sanghviharshit/wandering-hour-clock/(threads)

Thread 1 (2023-05-13):

Clock run backward

nxenara, 2023-05-13:
Hello,

The clock is running counterclockwise.
With this change the clock turns clockwise but commands, +5minutes, -5minutes, demo and recycle are still reversed.

<code> myStepper.step(-cStep); //inversion du mouvement, cStep modifié en -cStep </code>

This is certainly not the right solution.

Thank you for your help.

Nxenara

sanghviharshit, 2023-05-15:
I think there might be an issue with the wiring order. Have you tested it with a basic sketch from [ESP32](https://randomnerdtutorials.com/esp32-stepper-motor-28byj-48-uln2003/) or [ESP8266](https://randomnerdtutorials.com/esp8266-nodemcu-stepper-motor-28byj-48-uln2003/)?

Closed 2023-12-21.

Thread 2 (2023-08-21):

Your wiring diagram is not exactly what you have in ur pictures.

Bock326, 2023-08-21:
The schematic shows that both boards are connected to ground and only the stepper driver is power by 5v. In your image of your irl wiring 5v is also connected to the esp32

sanghviharshit, 2023-08-21:
The wiring diagram is from the tutorial I have linked, and it assumes you are powering your ESP32 board using the micro-usb port. I have decided to power the stepper motor and the board from the same power supply. Hope that helps!

Closed 2023-12-21.

Thread 3 (2023-12-12):

How to set up with wifi manager ?

kot0005, 2023-12-12:
How do i change your code to use it with wifi manager in this video : ?

this is to avoid compiling sketch for a new password and ssid.

https://www.youtube.com/watch?v=VnfX9YJbaU8&ab_channel=DroneBotWorkshop

garylefebvreg, 2024-01-05:
[](https://www.youtube.com/watch?v=VnfX9YJbaU8&t=1120s)

This link worked for me and I adjust the sketch code to use the WiFiManager from this video and clear out the sketch WiFi routine...

garylefebvreg, 2024-01-06:
Comment this out becaause WiFi will reset after power is turn off...

//wm.resetSettings();

kot0005, 2024-01-06:
> Comment this out becaause WiFi will reset after power is turn off...
>
> //wm.resetSettings();

i was askign chat GPT for this code and this is what it gave me. It wasnt working though.

#include <WiFiManager.h>
#include <Stepper.h>
#include <ArduinoOTA.h>
#include <WebServer.h>
#include <WiFiUdp.h>
#include <TimeLib.h>

// Function declarations
time_t getNtpMinute();
void setupWiFi();
void handleRoot();
void handleFormSubmit();
void handleFormForward5();
void handleFormBackward5();
void handleFormRecycle();
void handleFormDemo();

// Replace the ssid and password in secrets.h
const char* ssid = "your-ssid";
const char* password = "your-password";

const int stepsPerRev = 2048; // steps / rev for stepper motor
const int maxSpeed = 8;       // max speed stepper RPM, conservative
const int led = 13;           // built-in led

#define IN1 19
#define IN2 18
#define IN3 5
#define IN4 17

int stepDelay;      // minimum delay / step in uSec
unsigned int updateIntervalMinutes = 1;
unsigned long pMinute = 0;
unsigned long cMinute;
unsigned long cHour;
unsigned long pHour;

// Initialize web server library
WebServer server(80); // Create a WebServer object that listens on port 80

// Initialize the stepper library
Stepper myStepper(stepsPerRev, IN1, IN3, IN2, IN4);

// Initialize UDP library
WiFiUDP udp;
unsigned int localPort = 8888;  // local port to listen for UDP packets
int retryCount = 0;             // Wifi connection retry count
const int maxRetryCount = 10;   // Maximum number of retry attempts

// Define the NTP server and timezone offset
static const char ntpServerName[] = "us.pool.ntp.org";
const long timeZoneOffset = -7;  // Pacific Daylight Time (PDT)

void setupWiFi() {
  WiFiManager wifiManager;

  // Uncomment the next line to reset WiFi credentials (for testing purposes)
  // wifiManager.resetSettings();

  if (!wifiManager.autoConnect("AutoConnectAP", "password")) {
    Serial.println("Failed to connect and hit timeout");
    ESP.restart();
    delay(1000);
  }

  Serial.println("Connected to WiFi");
}

void setup() {
  Serial.begin(115200);
  Serial.println("Booting");

  // Setup Wi-Fi connection using WiFiManager
  setupWiFi();

  // Initialize the NTP client and sync with the NTP server
  udp.begin(localPort);
  Serial.print("NTP UDP Local port: ");
  Serial.println(localPort);

  Serial.println("waiting for sync");
  setSyncProvider(getNtpMinute);
  setSyncInterval(300);
  while (timeStatus() == timeNotSet) {
    delay(5000);
  }

  // Set up Arduino OTA

  // Hostname defaults to esp3232-[MAC]
  ArduinoOTA.setHostname("wandering-hour-clock");

  ArduinoOTA
    .onStart([]() {
      String type;
      if (ArduinoOTA.getCommand() == U_FLASH)
        type = "sketch";
      else // U_SPIFFS
        type = "filesystem";

      // NOTE: if updating SPIFFS this would be the place to unmount SPIFFS using SPIFFS.end()
      Serial.println("Start updating " + type);
    })
    .onEnd([]() {
      Serial.println("\nEnd");
    })
    .onProgress([](unsigned int progress, unsigned int total) {
      Serial.printf("Progress: %u%%\r", (progress / (total / 100)));
    })
    .onError([](ota_error_t error) {
      Serial.printf("Error[%u]: ", error);
      if (error == OTA_AUTH_ERROR) Serial.println("Auth Failed");
      else if (error == OTA_BEGIN_ERROR) Serial.println("Begin Failed");
      else if (error == OTA_CONNECT_ERROR) Serial.println("Connect Failed");
      else if (error == OTA_RECEIVE_ERROR) Serial.println("Receive Failed");
      else if (error == OTA_END_ERROR) Serial.println("End Failed");
    });

  ArduinoOTA.begin();

  // Set up the web server
  server.on("/", HTTP_GET, handleRoot);
  server.on("/submit", HTTP_POST, handleFormSubmit);
  server.on("/forward-5", HTTP_POST, handleFormForward5);
  server.on("/backward-5", HTTP_POST, handleFormBackward5);
  server.on("/recycle", HTTP_POST, handleFormRecycle);
  server.on("/demo", HTTP_POST, handleFormDemo);

  server.begin(); // Start the server

  pinMode(led, OUTPUT);

  myStepper.setSpeed(maxSpeed);

  time_t currentTime = now();
  // Convert the Unix time to local time
  tm localTime = *localtime(&currentTime);

  cMinute = pMinute = localTime.tm_min;
  cHour = pHour = localTime.tm_hour % 12;

  // Start up cycle
  handleFormRecycle();
}

void loop() {
  // Handle web server requests
  server.handleClient();

  // Handle Arduino OTA updates
  ArduinoOTA.handle();

  // Add any other continuous tasks or logic you need
}

// Add the missing part here

kot0005, 2024-01-06:
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

damm thats a really big sketch !! could you attach a note pad file instead please ? the github forums are adding unecessary stuff in to the code.

Thread 5 (2024-01-05):

Hello, Ihave the components all wired perfectly, but the servo motor gets extremely hot. It seems as thou the motor stays engaged all of the time. Should I be worried or maybe something else is wrong, not sure where to go from here... Thank you, kind regards

garylefebvreg, 2024-01-05:

Closed 2024-01-06.
