sanghviharshit/wandering-hour-clock/(commit log)

2023-12-19 Fixed setting hostname (at least for esp32 V2.0.14)
    [wandering-hour-clock.ino]
2023-12-21 Reverted hostname back to "wandering-hour-clock"
    [wandering-hour-clock.ino]
2026-03-21 Add CLAUDE.md with comprehensive codebase documentation
    Documents project structure, hardware platform, Arduino library dependencies,
    code architecture (setup/loop flow, motor math, NTP sync), web server endpoints,
    preferences storage, WiFi/OTA behavior, build instructions, and development
    conventions for AI assistants working on this codebase.
2026-03-21 Make clock resilient to WiFi and internet unavailability
    Previously the device entered an infinite reboot loop when WiFi was
    unavailable at startup, and hung indefinitely if NTP was unreachable.
    Changes:
    - setupWiFi() now returns bool and never calls ESP.restart(). After
    maxRetryCount attempts it returns false and the clock continues
    running without network access.
    - setup() uses wifiAvailable to gate NTP wait, OTA, and mDNS:
    - NTP wait is bounded to 30 seconds (was infinite)
    - OTA and mDNS are only initialized when WiFi is available
    - Web server is always started (becomes reachable once WiFi connects)
    - If WiFi is unavailable at boot, motor still runs on the recycle
    cycle;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
2026-04-06 Add MQTT integration with Home Assistant auto-discovery
    Integrate PubSubClient for MQTT connectivity with Home Assistant:
    - Add MQTT credentials to secrets.h (server, port, username, password)
    - Publish auto-discovery messages for sensors (clock time, WiFi RSSI) and buttons (forward 5m, backward 5m, recycle, demo)
    - Implement mqttCallback() to handle commands: forward-5, backward-5, recycle, demo, and set:HH:MM for manual time adjustment
    - Add mqttConnect() with LWT on availability topic and automatic discovery on first
